Saweenbarra/DueFinn/test/MiddleC/comparison.png

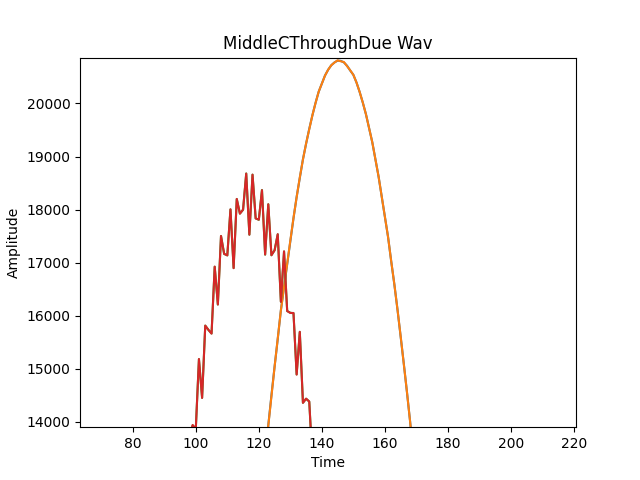
test/MiddleC/comparison.png
