Saweenbarra/DueFinn/test/MiddleC/PureCSpectrum.png

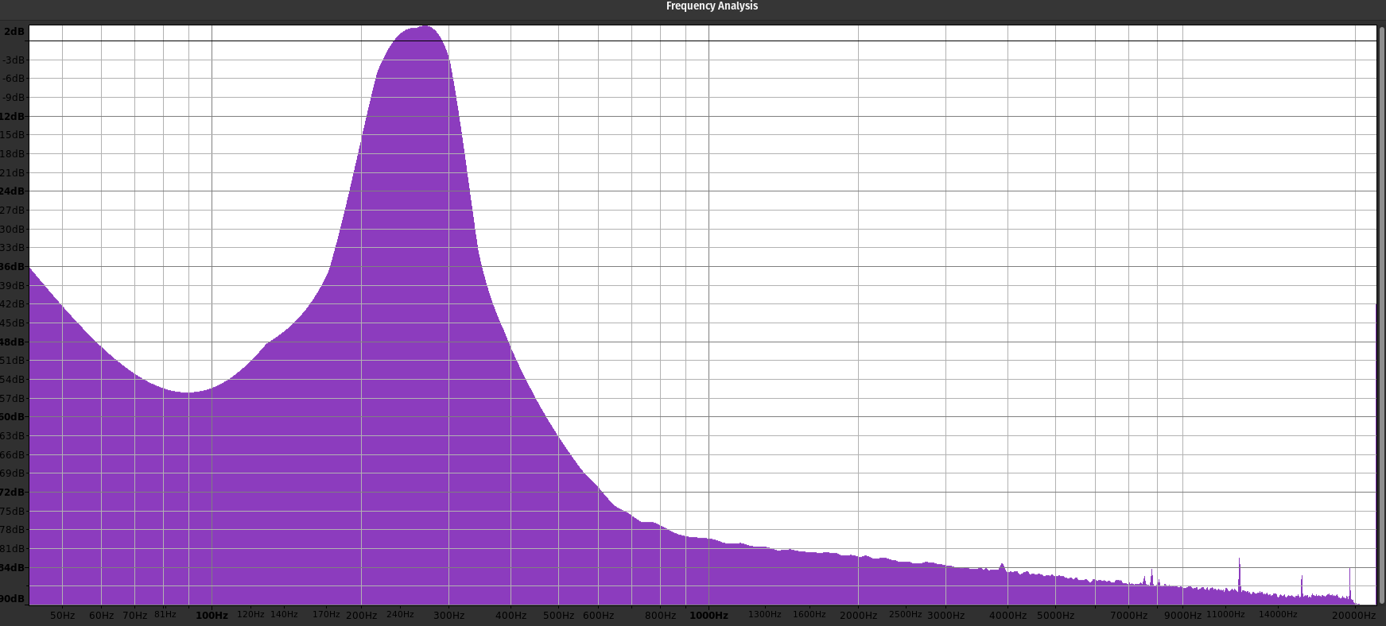
test/MiddleC/PureCSpectrum.png
