Saweenbarra/DueFinn/(commit log)

2020-09-17 SAM3X power and USB con included
    [DueFinn.sch]
2020-09-18 Added SD card, finished ATSAM3X
    [DueFinn.sch]
2020-10-27 Added images of schematic and test files
    [DueFinn.sch]
2020-10-27 Add prototype image
